arlinjv/KC-basic/Kelly controller.pdf

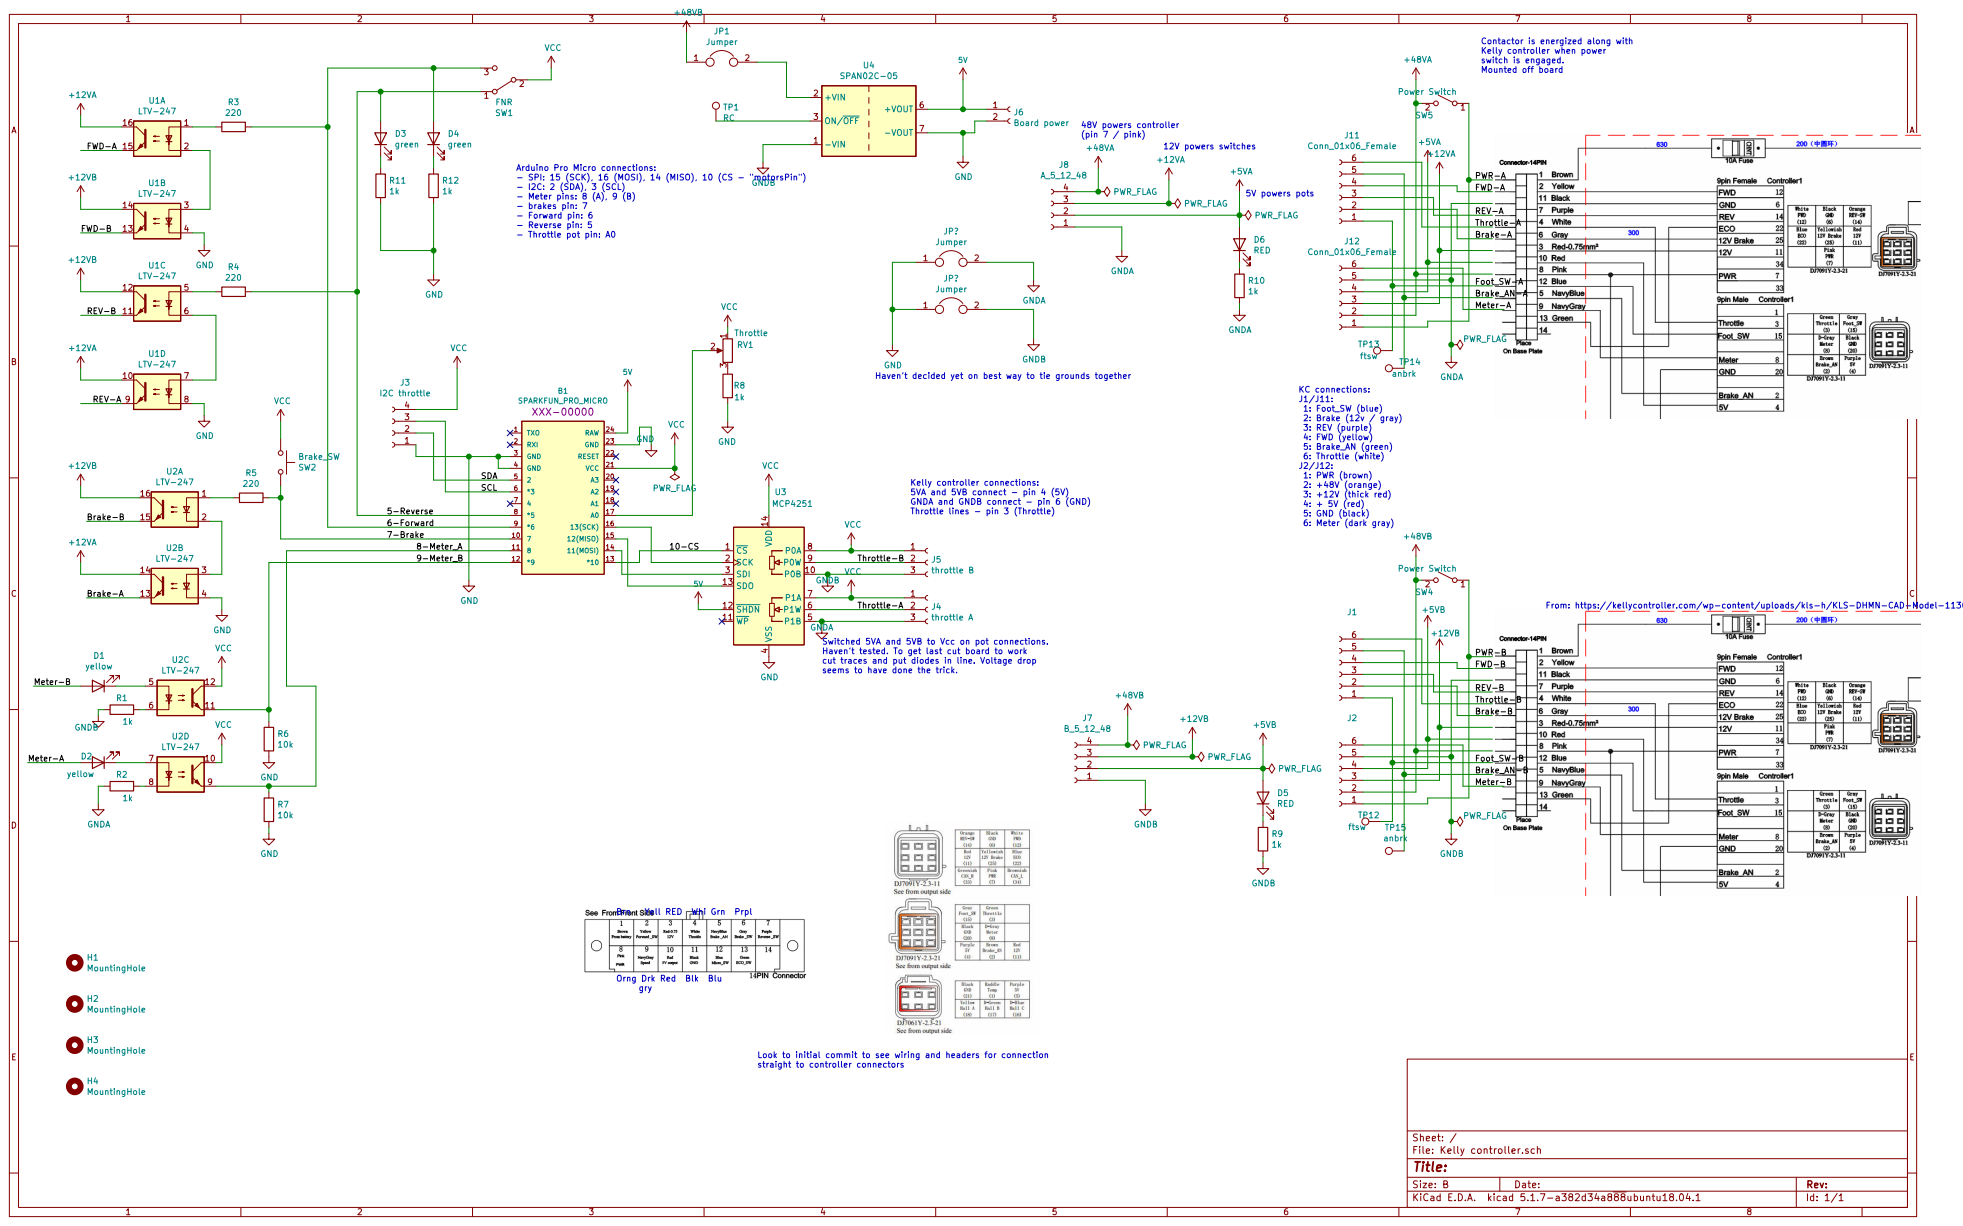
[picture p1: page 1]

Contactor is energized along with
Kelly controller when power

switch is engaged. Mounted off board Kelly controller connections:

5V powers pots Arduino Pro Micro connections: - SPI: 15 (SCK), 16 (MOSI), 14 (MISO), 10 (CS - "motorsPin")

Haven't decided yet on best way to tie grounds together

5VA and 5VB connect - pin 4 (5V)
GNDA and GNDB connect - pin 6 (GND)

From: https://kellycontroller.com/wp-content/uploads/kls-h/KLS-DHMN-CAD-Model-1130.pdf

Switched 5VA and 5VB to Vcc on pot connections.
Haven't tested. To get last cut board to work
cut traces and put diodes in line. Voltage drop
seems to have done the trick.

Brn Yell RED Whi Grn Prpl

Orng Drk Red Blk Blu
gry

Look to initial commit to see wiring and headers for connection
straight to controller connectors

File: Kelly controller.sch Sheet: /
