arlinjv/KC-basic/Kelly controller.kicad_pcb

## KiCad design Kelly controller.kicad_pcb (2022-05-21)

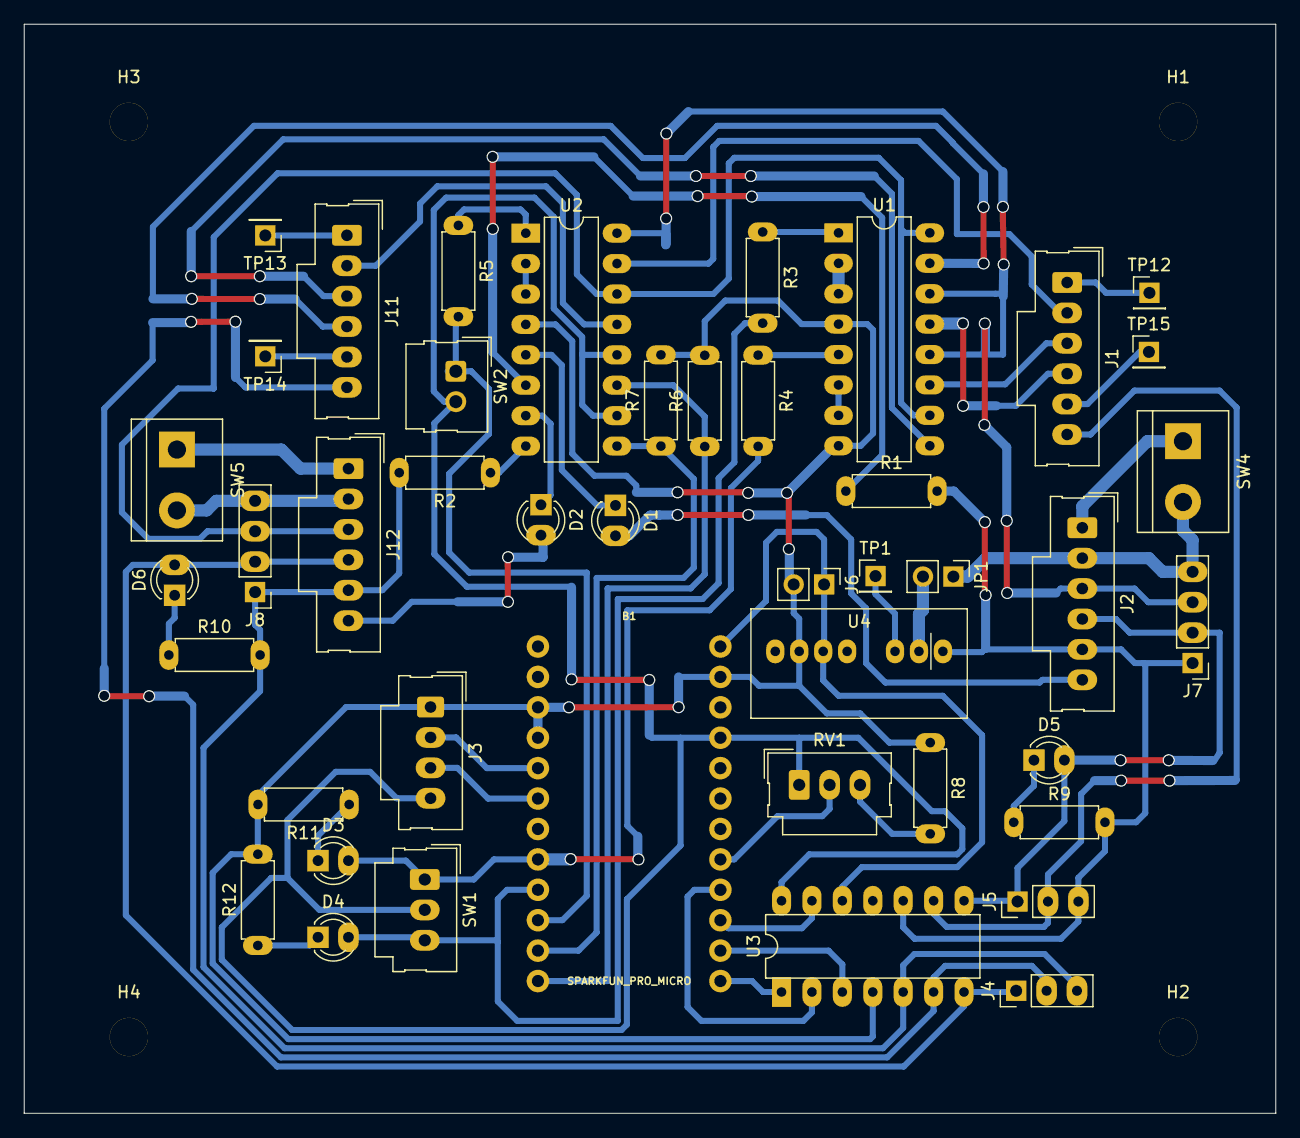
[picture p2: board Kelly controller.kicad_pcb from above]

Board: 2 copper layers, 104.5 x 91.0 mm, 48 parts (0 on the bottom side), 56 nets.

Parts:
B1: SPARKFUN_PRO_MICRO
D1, D2: yellow; LED_D3.0mm_wide_pads
D3, D4: green; LED_D3.0mm_wide_pads
D5, D6: RED; LED_D3.0mm_wide_pads
H1, H2, H3, H4: MountingHole; MountingHole_3.2mm_M3_through_hole
J1, J2, J11, J12: Conn_01x06_Female; Molex_SL_171971-0006_1x06_P2.54mm_Vertical
J3: I2C throttle; Molex_SL_171971-0004_1x04_P2.54mm_Vertical_wide_pads
J4: throttle A; PinHeader_1x03_P2.54mm_Vertical_wide_pads
J5: throttle B; PinHeader_1x03_P2.54mm_Vertical_wide_pads
J6: Board power; PinHeader_1x02_P2.54mm_Vertical
J7: B_5_12_48; PinHeader_1x04_P2.54mm_Vertical_wide_pads
J8: A_5_12_48; PinHeader_1x04_P2.54mm_Vertical_wide_pads
JP1: Jumper; PinHeader_1x02_P2.54mm_Vertical
R1, R2, R8, R9, R10, R11, R12: 1k; R_Axial_DIN0207_L6.3mm_D2.5mm_P7.62mm_Horizontal_wide_pads
R3, R4, R5: 220; R_Axial_DIN0207_L6.3mm_D2.5mm_P7.62mm_Horizontal_wide_pads
R6, R7: 10k; R_Axial_DIN0207_L6.3mm_D2.5mm_P7.62mm_Horizontal_wide_pads
RV1: Throttle; Molex_SL_171971-0003_1x03_P2.54mm_Vertical_wide_pads
SW1: FNR; Molex_SL_171971-0003_1x03_P2.54mm_Vertical_wide_pads
SW2: Brake_SW; Molex_SL_171971-0002_1x02_P2.54mm_Vertical
SW4, SW5: Power Switch; TerminalBlock_bornier-2_P5.08mm
TP1: RC; PinHeader_1x01_P2.54mm_Vertical
TP12, TP13: ftsw; PinHeader_1x01_P2.54mm_Vertical
TP14, TP15: anbrk; PinHeader_1x01_P2.54mm_Vertical
U1, U2: LTV-247; DIP-16_W7.62mm_LongPads
U3: MCP4251; DIP-14_W7.62mm
U4: SPAN02C-05; SPAN02

Connections:
5V: B1.24, J6.1, U3.12, U4.6
+5VA: D6.2, J4.1, J8.2, J12.4, U3.7
+5VB: D5.2, J2.4, J5.1, J7.2, U3.8
+12VA: J8.3, J12.3, U1.10, U1.16, U2.14
+12VB: J2.3, J7.3, U1.12, U1.14, U2.16
+48VA: J8.4, J12.2, SW5.2
+48VB: J2.2, J7.4, JP1.1, SW4.2
/5-Reverse: B1.8, D3.2, R4.2, SW1.1
/6-Forward: B1.9, D4.2, R3.2, SW1.3
/7-Brake: B1.10, R5.2, SW2.1
/8-Meter_A: B1.11, R7.1, U2.9
/9-Meter_B: B1.12, R6.1, U2.11
/10-CS: B1.13, U3.1
/Brake-A: J11.2, U2.13
/Brake-B: J1.2, U2.15
/Brake_AN-A: J11.5, TP14.1
/Brake_AN-B: J1.5, TP15.1
/FWD-A: J11.4, U1.15
/FWD-B: J1.4, U1.13
/Foot_SW-A: J11.1, TP13.1
/Foot_SW-B: J1.1, TP12.1
/Meter-A: D2.2, J12.6
/Meter-B: D1.2, J2.6
/PWR-A: J12.1, SW5.1
/PWR-B: J2.1, SW4.1
/REV-A: J11.3, U1.9
/REV-B: J1.3, U1.11
/SCL: B1.6, J3.3
/SDA: B1.5, J3.2
/Throttle-A: J4.2, J11.6, U3.6
/Throttle-B: J1.6, J5.2, U3.9
GND: B1.3, B1.4, B1.23, J3.1, J6.2, R6.2, R7.2, R8.1, R11.2, R12.2, U1.4, U1.8, U2.4, U3.4, U4.7
GNDA: J4.3, J8.1, J12.5, R2.2, R10.2, U3.5
GNDB: J2.5, J5.3, J7.1, R1.2, R9.2, U3.10, U4.1
unnamed: B1.14, U3.3
unnamed: B1.15, U3.13
unnamed: B1.16, U3.2
unnamed: B1.17, RV1.2
unnamed: D1.1, U2.5
unnamed: D2.1, U2.7
unnamed: D3.1, R11.1
unnamed: D4.1, R12.1
unnamed: D5.1, R9.1
unnamed: D6.1, R10.1
unnamed: JP1.2, U4.2
unnamed: R1.1, U2.6
unnamed: R2.1, U2.8
unnamed: R3.1, U1.1
unnamed: R4.1, U1.5
unnamed: R5.1, U2.1
unnamed: R8.2, RV1.3
unnamed: TP1.1, U4.3
unnamed: U1.2, U1.3
unnamed: U1.6, U1.7
unnamed: U2.2, U2.3
VCC: B1.21, J3.4, RV1.1, SW1.2, SW2.2, U2.10, U2.12, U3.14
