arlinjv/KC-basic/(commit log)

2021-11-02 first commit
    First version was used to finish out test platform
    Next goal with this board is to have control boards for first prototype
    mcu incorporation will come later
    [Kelly controller.kicad_pcb, Kelly controller.sch]
2021-11-02 removed auto connectors and added assembly connector
    [Kelly controller.sch]
2021-11-02 Deleted old schematic from repository
    [Kelly controller.kicad_pcb]
2021-11-03 PCB routed and ready for cutting
    [Kelly controller.kicad_pcb, Kelly controller.sch]
2021-11-05 created gerber files
    [Kelly controller-B_Cu.gbr, Kelly controller-Edge_Cuts.gbr, Kelly controller-F_Cu.gbr, Kelly controller-NPTH.drl, Kelly controller-PTH.drl, Kelly controller-job.gbrjob]
2021-11-05 updated vias
    [Kelly controller.kicad_pcb]
2021-11-05 trying to fix via sizes
    [Kelly controller.kicad_pcb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]
2021-11-05 Split 12 pin connector realized did not have 12 pin connector so split roughly into power and controls cables redid pcb layout and exported gerbers;
    [Kelly controller.kicad_pcb, Kelly controller.sch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]
2021-11-06 first board cut and connected successfully
    some minor changes to make before cutting second board, including removing battery connector and flipping some connectors
    [Kelly controller.sch]
2021-11-07 Ready to cut second board
    Thickened 12V traces and removed batt connector which was superfluous
    [Kelly controller.kicad_pcb, Kelly controller.sch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]
2022-01-07 minor routing changes to improve cutting time
    [Kelly controller.kicad_pcb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]
2022-03-26 saving most recent changes in preparation for moving to mcu based schematics
    [Kelly controller.sch]
2022-04-10 redid board. vias were too small and close together. Also changed many pads to oval
    [Kelly controller.kicad_pcb, Kelly controller.sch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]
2022-04-21 Cut first attempt at twin motor arduino board. During assembly had several lifted pads - need to use wider traces where practical. Brake lines were wired wrong. See notes in this commit for history. 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
    [Kelly controller.kicad_pcb, Kelly controller.sch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]
2022-05-21 Last version of mcp4251 based board. Too many problems but ultimately got to work by combining grounds and putting diodes in line with pot high side to get lower that Arduino Vcc. Next version will u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
    [Kelly controller.kicad_pcb, Kelly controller.kicad_pcb.kicad_pcb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]
2022-05-22 Getting ready to move on to new version without digital pots. Added some notes re. how got last board to work. Added jumpers to tie grounds together. Next version will be dead simple dual pot board. 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
    [Kelly controller.sch]
2022-05-22 saved pdf of schematic for easy reference on github
